EIT-team/Mini_CS_Altium/Project Outputs for Mini_CS/Mini_CS_BOM.xlsx

Value | Pattern | Quantity | Components | Descritpion | Part number | Supplied
100k | 6-0805_M | 4 | R5, R6, R11, R12 | Resistor | CPF-A-0805B100KE1 | Customer Supplied
0.1uF | 1608[0603] | 7 | C4, C6, C8, C9, C10, C11, C14 | Capacitor (Semiconductor SIM Model) | MC0603B104K500CT | PCB Train free components
10k | 6-0805_M | 3 | R1, R4, R9 | Resistor | CPF-A-0805B10KE1 | Customer Supplied
10nF | 1608[0603] | 1 | C5 | Capacitor (Semiconductor SIM Model) | MC0603B103K500CT | PCB Train free components
10uF | 1608[0603] | 3 | C7, C12, C13 | Capacitor (Semiconductor SIM Model) | GRM188C80E106ME47D | Customer Supplied
13k | 6-0805_M | 1 | R3 | Resistor | MC01W0805113K | PCB Train free components
1uF | 1608[0603] | 1 | C2 | Capacitor (Semiconductor SIM Model) | MC0603X105K250CT | PCB Train free components
2.2nF | 1608[0603] | 1 | C3 | Capacitor (Semiconductor SIM Model) | MC0603B222K500CT | PCB Train free components
20k | 6-0805_M | 2 | R8, R14 | Resistor | CPF-A-0805B20KE1 | Customer Supplied
220pF | 1608[0603] | 1 | C1 | Capacitor (Semiconductor SIM Model) | MC0603N221J500CT | PCB Train free components
330 | 6-0805_M | 1 | R13 | Resistor | MC01W08051330R | PCB Train free components
50k | 6-0805_M | 1 | R7 | Resistor | ERA6AEB513V | Customer Supplied
5k | 6-0805_M | 1 | R10 | Resistor | CPF-A-0805B5K1E1 | Customer Supplied
715 | 6-0805_M | 1 | R2 | Resistor | ERJ6ENF7150V | Customer Supplied
AD9833BRMZ | ADI-RM-10_M | 1 | U2 | Low Power, 12.65 mW, 2.3 V to 5.5 V, Programmable Waveform Generator, 10-Bit, Serial, RM-10, 50 Tube, Pb-Free | AD9833BRMZ | Customer Supplied
ADG731BSUZ | ADI-SU-48_N | 2 | U4, U5 | 1.8 to 5.5 V / +/-2.5 V, 4 Ohm, Serially Controlled, 32-Channel Analog Multiplexer, -40 to 85 degC, 48-pin QFP (SU-48), Tray |  | Customer Supplied
Header 16X2 | FTSH-117-XX-XXX-DH | 1 | P4 | Header, 16-Pin, Dual row |  | Customer Supplied
Header 4X2 | HDR2X4 | 2 | P1, P5 | Header, 4-Pin, Dual row | 2213S-08G | Customer Supplied
LTC1044ACS8 | LT-S8-8_M | 1 | U6 | 12 V CMOS Voltage Converter, 8-pin SOIC (S8-8), 0 to 70 degC | LTC1044CS8#PBF | Customer Supplied
LTC6900IS5#PBF | LT-TSOT-23-5_V | 1 | U7 | Low Power, Resistor Set Oscillator, 1 KHz to 20 MHz, 2.7 to 5.5 V, -40 to 85 degC, 5-Pin SOT-23 (S5), Pb-Free | LTC6900CS5#TRMPBF | Customer Supplied
OPA2188AIDR | D0008A_L | 2 | U1, U3 | 0.03 uV/degC, 6 uV Vos, Low Noise, Rail-to-Rail Output, Zero-Drift Operational Amplifier, 4 to 36 V, -40 to 105 degC, 8-pin SOIC (D8), Green (RoHS & no Sb/Br) | OPA2188AIDR | Customer Supplied
TLMS1100-GS08 | VISH-TLMX1100_V | 1 | DS1 | LED, RED, 2.1 V, -40 to 100 degC, 2-Pin SMD (0603), RoHS, Tape and Reel | TLMS1100-GS08 | Customer Supplied
