EIT-team/Mini_CS_Altium/Project Outputs for Mini_CS/Mini_CS_BOM.xls

Comment | Value | Description | Designator | Footprint | LibRef | Quantity | PCBTrain free component? | Farnell Reference
150pF | 150pF | Capacitor (Semiconductor SIM Model) | C1 | 1608[0603] | Cap Semi | 1 | PCBTrain Free Component | 1759068
1.5nF | 1.5nF | Capacitor (Semiconductor SIM Model) | C2, C3 | 1608[0603] | Cap Semi | 2 | PCBTrain Free Component | 1759091
0.1uF | 0.1uF | Capacitor (Semiconductor SIM Model) | C4, C6, C8, C9, C10, C11, C14 | 1608[0603] | Cap Semi | 7 | PCBTrain Free Component | 1759037
10nF | 10nF | Capacitor (Semiconductor SIM Model) | C5 | 1608[0603] | Cap Semi | 1 | PCBTrain Free Component | 1759102
10uF | 10uF | Capacitor (Semiconductor SIM Model) | C7, C12, C13 | 1608[0603] | Cap Semi | 3 | Customer supplied
TLMS1100-GS08 |  | LED, RED, 2.1 V, -40 to 100 degC, 2-Pin SMD (0603), RoHS, Tape and Reel | DS1 | VISH-TLMX1100_V | CMP-1666-00027-1 | 1 | Customer supplied
MHDR2X18 |  | Header, 18-Pin, Dual row - Omnetics | P3 | A79025-001 | MHDR2X18 | 1 | Customer supplied
Header 16X2 |  | Header, 16-Pin, Dual row - SAMTEC | P4 | FTSH-117-XX-XXX-DH | Header 16X2 | 1 | Customer supplied
Header 4X2 |  | Header, 4-Pin, Dual row | P5 | HDR2X4 | Header 4X2 | 2 | Customer supplied
10k (0.1%) | 10k | Resistor | R1, R9 | 6-0805_M | Res1 | 2 | Customer supplied
1.1k | 1.1k | Resistor | R2 | 6-0805_M | Res1 | 1 | PCBTrain Free Component | 2350953
9.1k | 9.1k | Resistor | R3 | 6-0805_M | Res1 | 1 | PCBTrain Free Component | 2129193
1k | 1k | Resistor | R4 | 6-0805_M | Res1 | 1 | PCBTrain Free Component | 2129113
0.1% | 100K | Resistor | R5, R6, R11, R12 | 6-0805_M | Res1 | 4 | Customer supplied
50k | 50k | Resistor | R7 | 6-0805_M | Res1 | 1 | Customer supplied
20k | 20k | Resistor | R8, R14 | 6-0805_M | Res1 | 2 | Customer supplied
5k | 5k | Resistor | R10 | 6-0805_M | Res1 | 1 | Customer supplied
330 | 330 | Resistor | R13 | 6-0805_M | Res1 | 1 | PCBTrain Free Component | 2129074
OPA2188AIDR |  | 0.03 uV/degC, 6 uV Vos, Low Noise, Rail-to-Rail Output, Zero-Drift Operational Amplifier, 4 to 36 V, -40 to 105 degC, 8-pin SOIC (D8), Green (RoHS & no Sb/Br) | U1, U3 | D0008A_L | CMP-0272-00241-3 | 2 | Customer supplied
AD9833BRMZ |  | Low Power, 12.65 mW, 2.3 V to 5.5 V, Programmable Waveform Generator, 10-Bit, Serial, RM-10, 50 Tube, Pb-Free | U2 | ADI-RM-10_M | CMP-0293-00077-1 | 1 | Customer supplied
ADG731BSUZ |  | 1.8 to 5.5 V / +/-2.5 V, 4 Ohm, Serially Controlled, 32-Channel Analog Multiplexer, -40 to 85 degC, 48-pin QFP (SU-48), Tray | U4, U5 | ADI-SU-48_N | CMP-0798-00240-1 | 2 | Customer supplied
LTC1044ACS8 |  | 12 V CMOS Voltage Converter, 8-pin SOIC (S8-8), 0 to 70 degC | U6 | LT-S8-8_M | CMP-0475-00491-1 | 1 | Customer supplied
LTC6900IS5#PBF |  | Low Power, Resistor Set Oscillator, 1 KHz to 20 MHz, 2.7 to 5.5 V, -40 to 85 degC, 5-Pin SOT-23 (S5), Pb-Free | U7 | LT-TSOT-23-5_V | CMP-2000-06612-1 | 1 | Customer supplied
