EIT-team/Mini_CS_Altium/Mini_CS.pdf

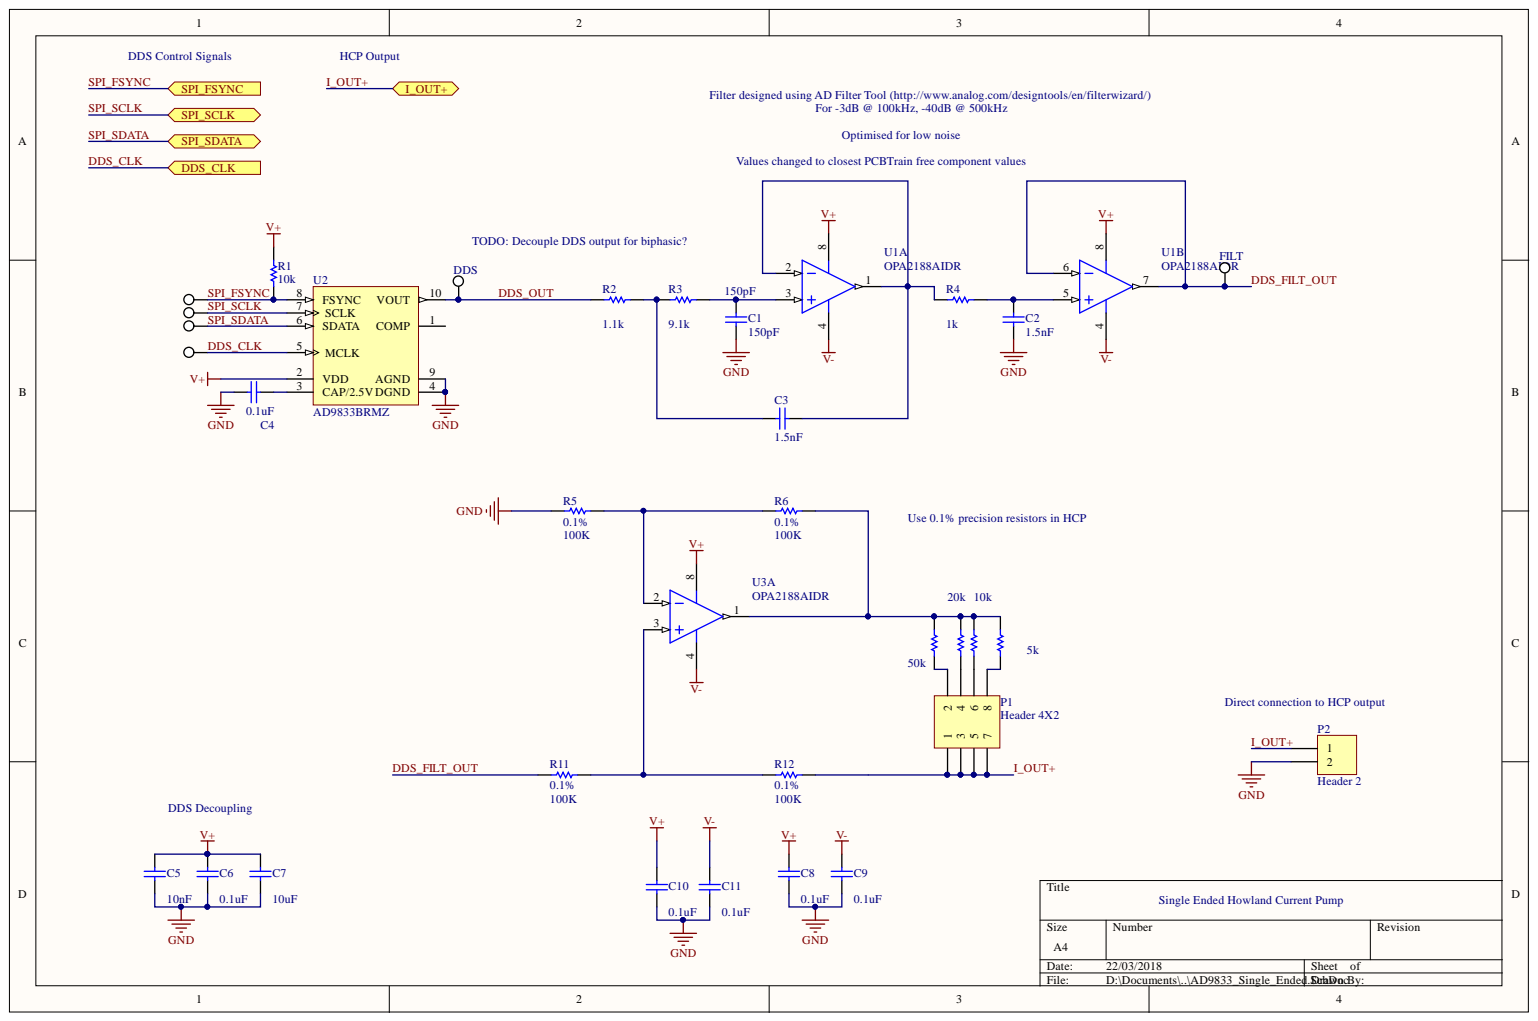
[picture p8: page 1]

Filter designed using AD Filter Tool (http://www.analog.com/designtools/en/filterwizard/)

Optimised for low noise

Values changed to closest PCBTrain free component values

TODO: Decouple DDS output for biphasic?

Use 0.1% precision resistors in HCP

Direct connection to HCP output

Single Ended Howland Current Pump

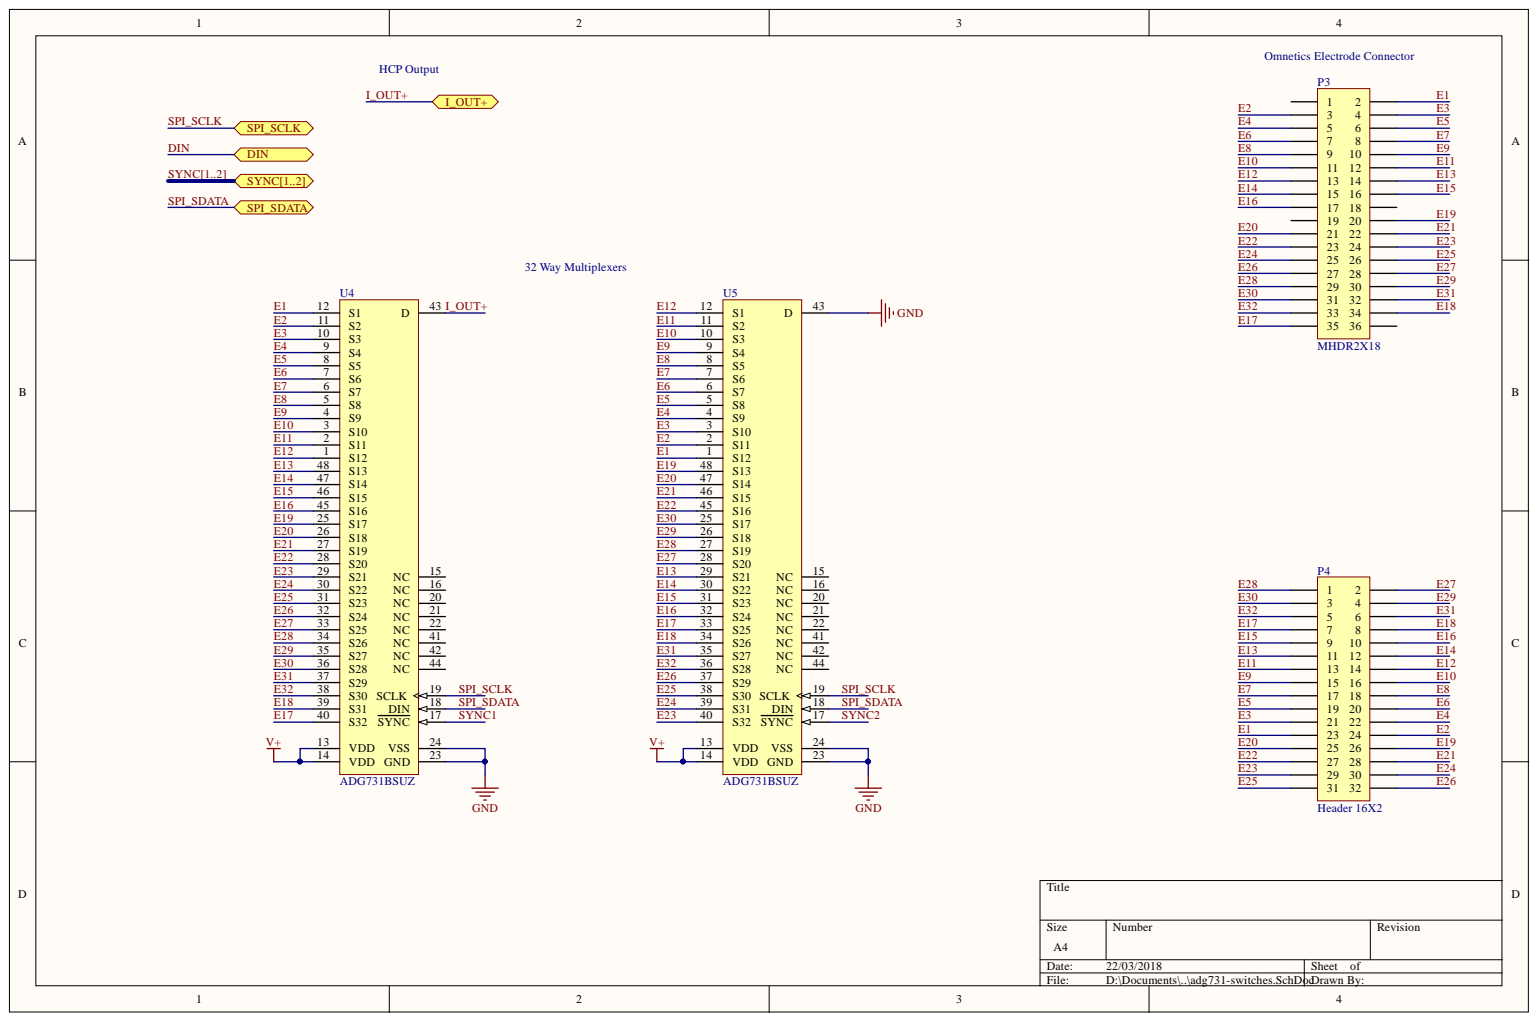
[picture p9: page 2]

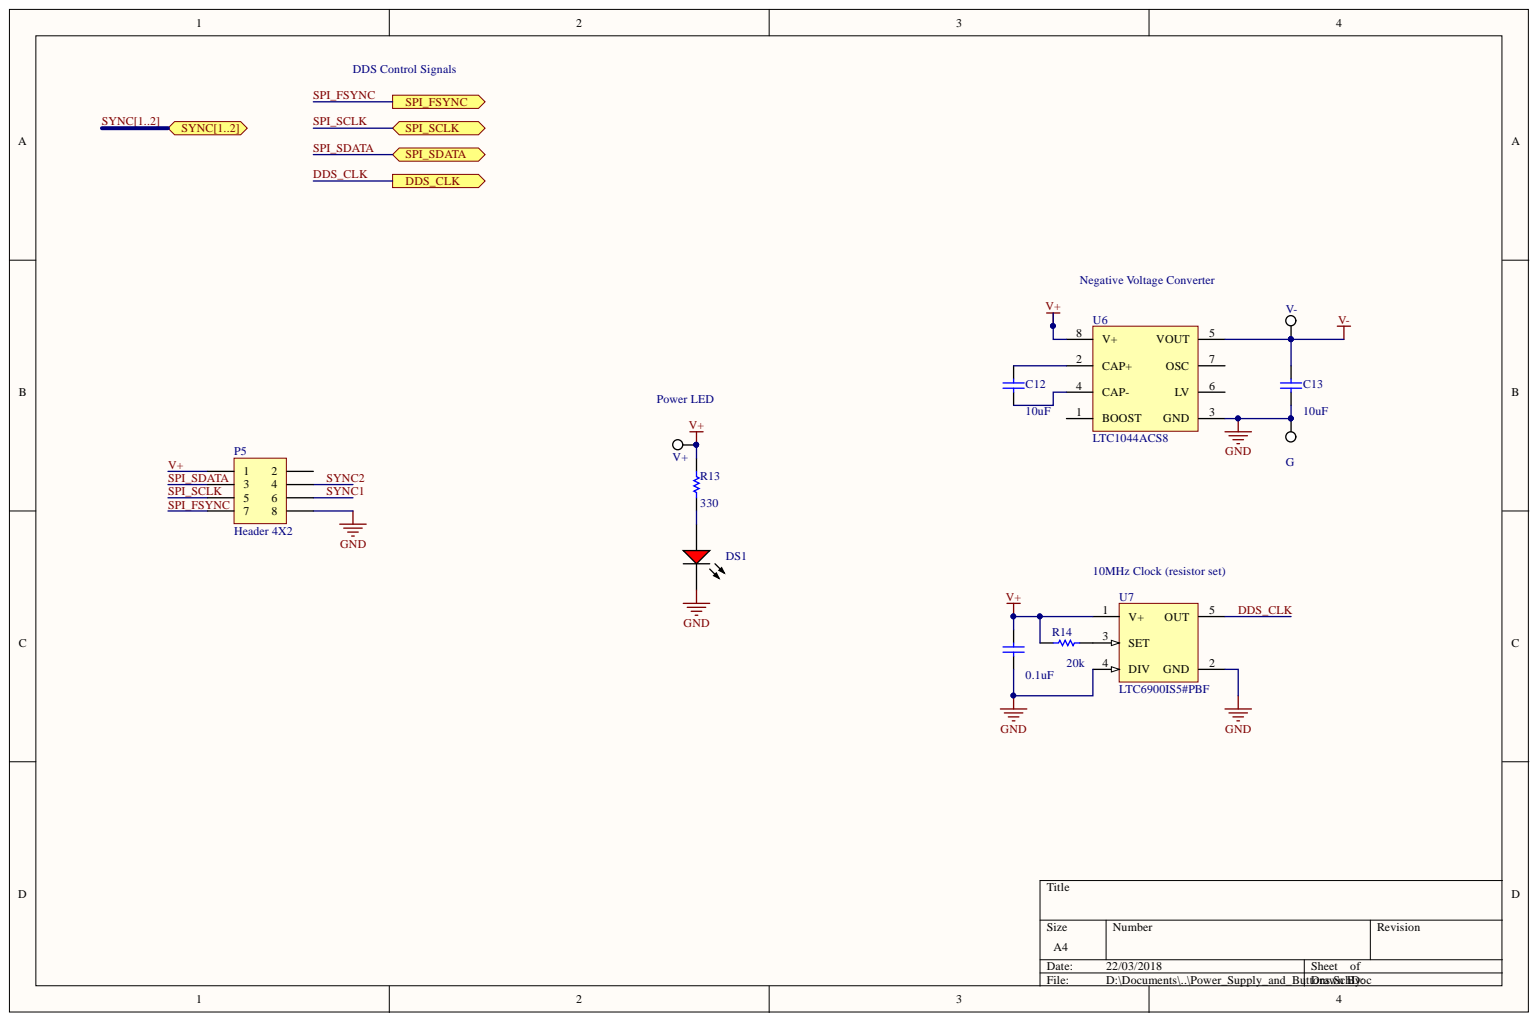
[picture p10: page 3]

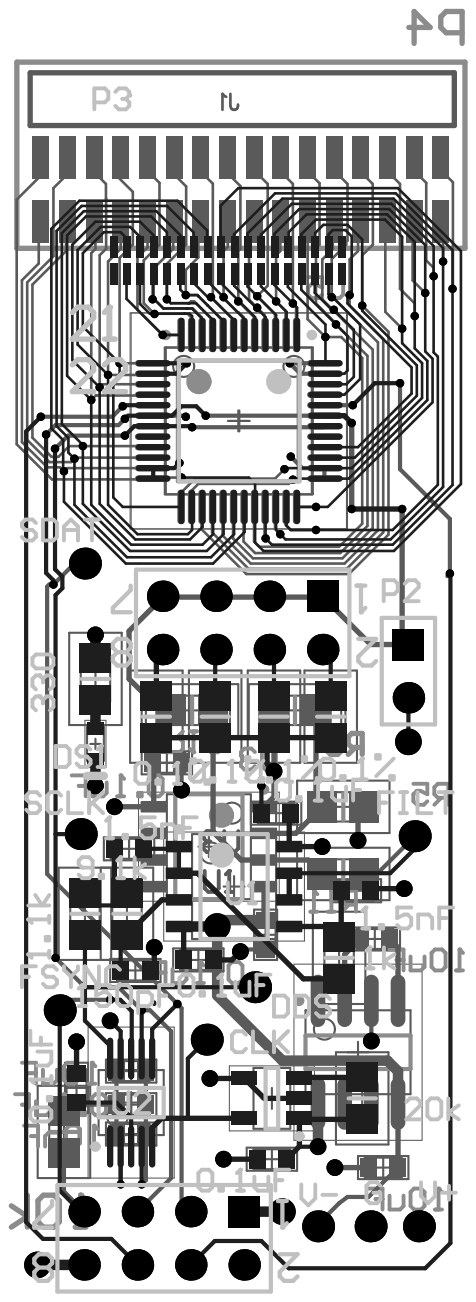
[picture p11: page 4]

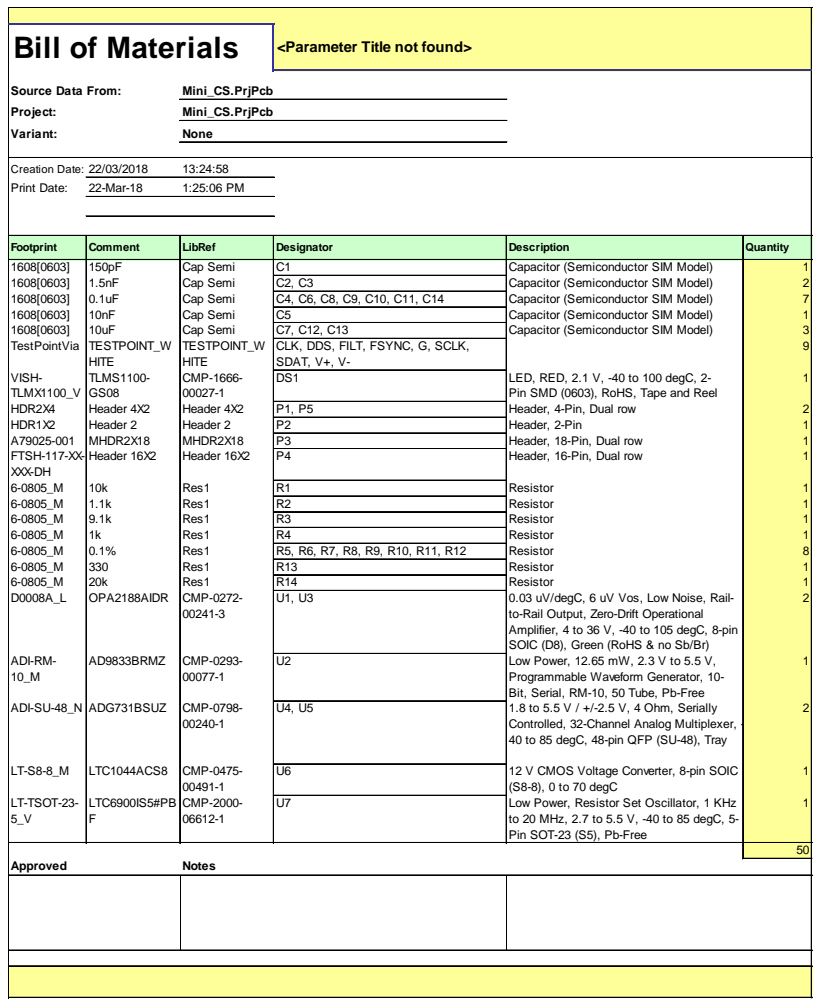
[picture p12: page 5]

CLK, DDS, FILT, FSYNC, G, SCLK,
SDAT, V+, V-

Pin SMD (0603), RoHS, Tape and Reel

to-Rail Output, Zero-Drift Operational
Amplifier, 4 to 36 V, -40 to 105 degC, 8-pin
SOIC (D8), Green (RoHS & no Sb/Br)

Programmable Waveform Generator, 10-
Bit, Serial, RM-10, 50 Tube, Pb-Free

Controlled, 32-Channel Analog Multiplexer, -
40 to 85 degC, 48-pin QFP (SU-48), Tray

to 20 MHz, 2.7 to 5.5 V, -40 to 85 degC, 5-
Pin SOT-23 (S5), Pb-Free
