EIT-team/Mini_CS_Altium/doc/Mini_CS.pdf

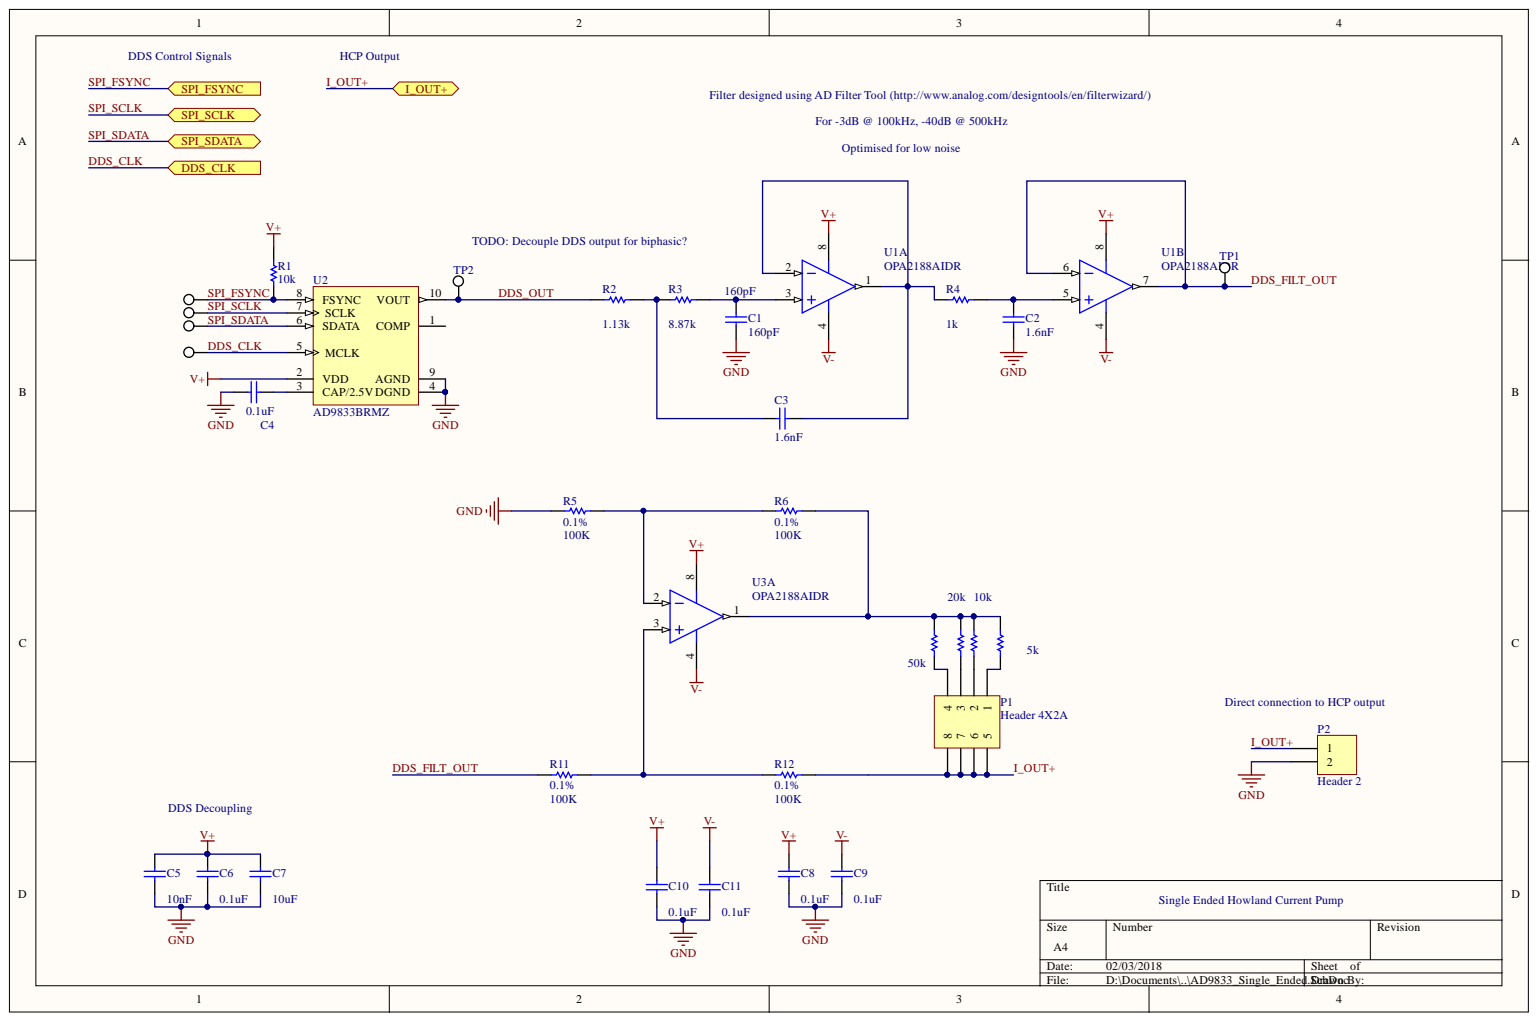
[picture p13: page 1]

Filter designed using AD Filter Tool (http://www.analog.com/designtools/en/filterwizard/)

Optimised for low noise

TODO: Decouple DDS output for biphasic?

Direct connection to HCP output

Single Ended Howland Current Pump

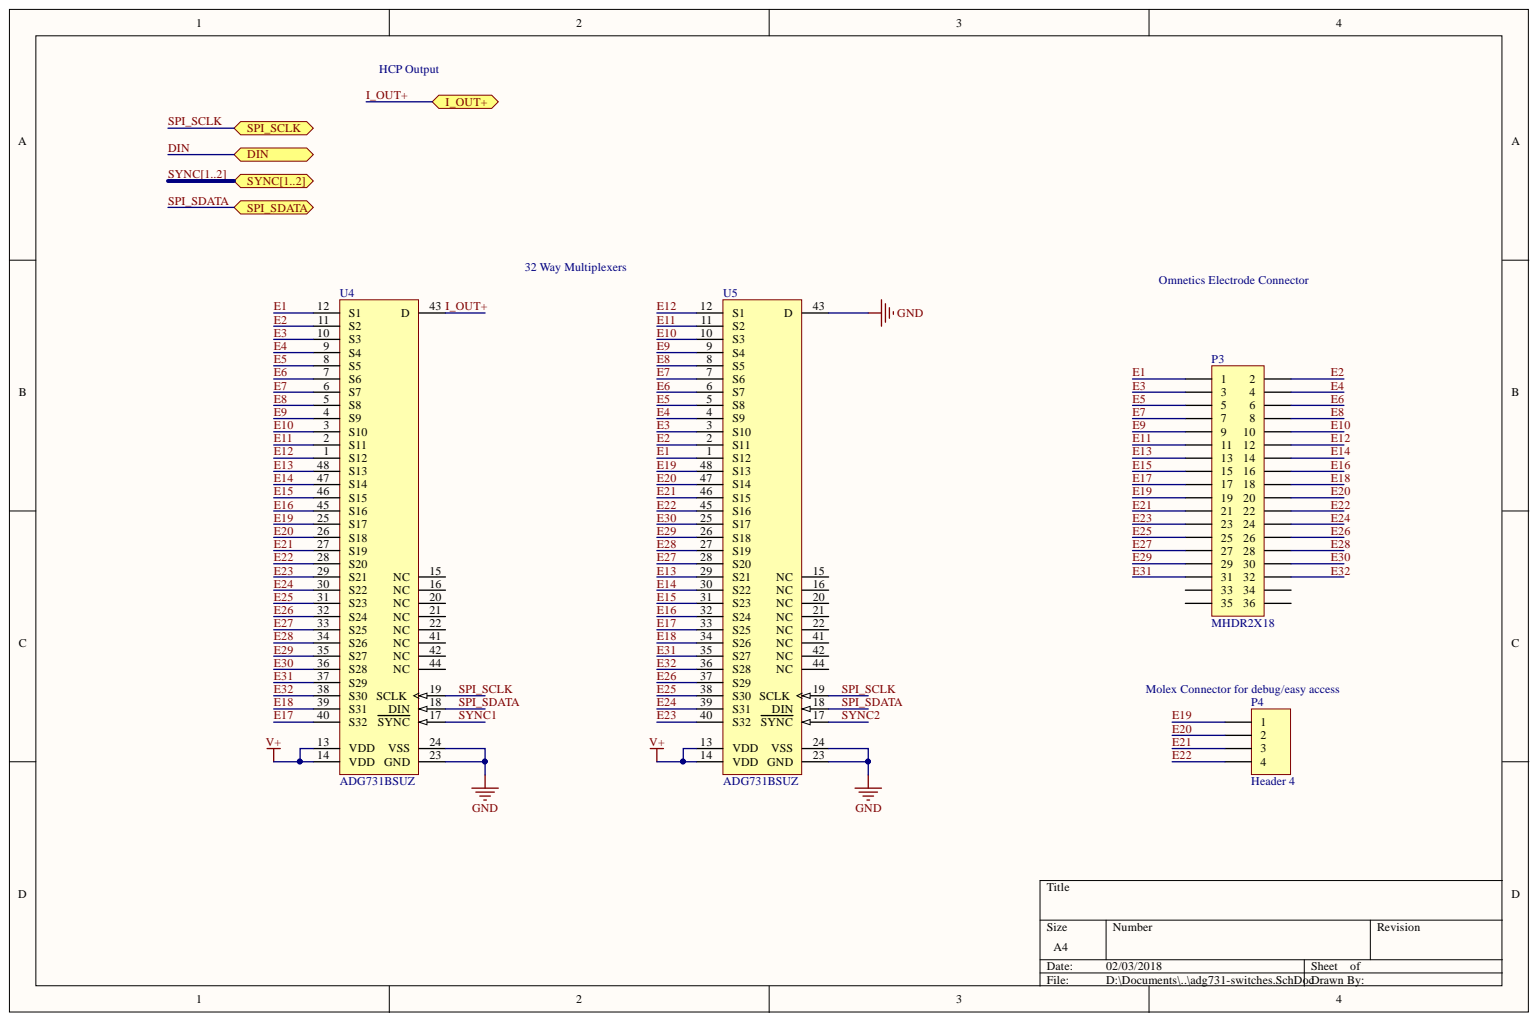
[picture p14: page 2]

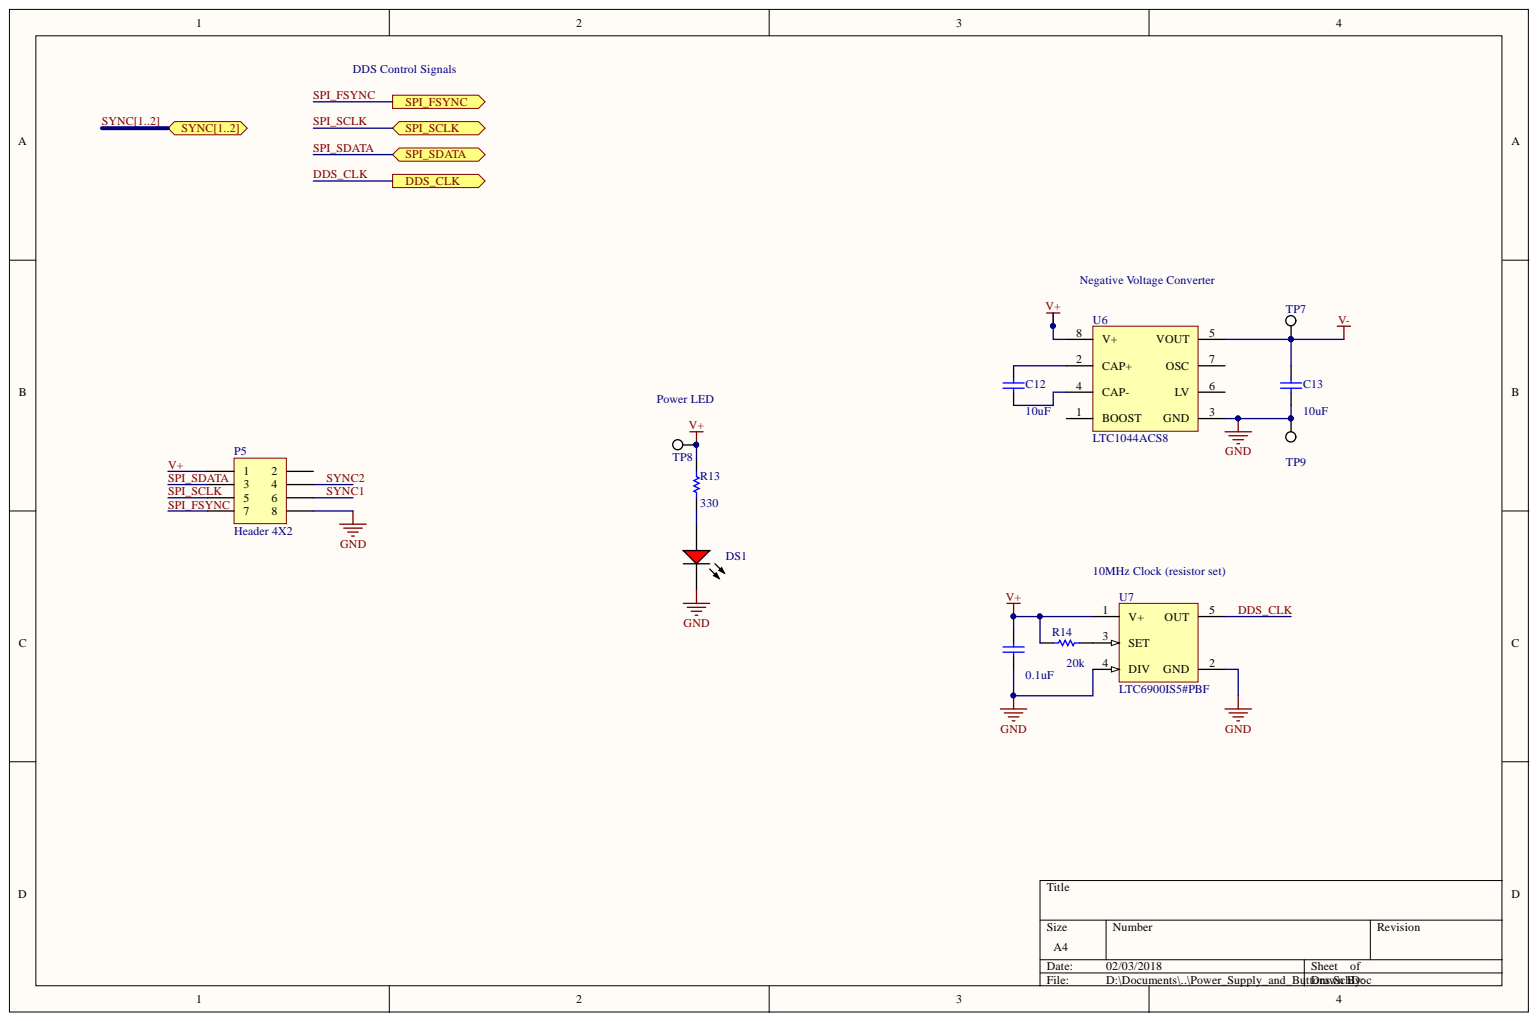
[picture p15: page 3]

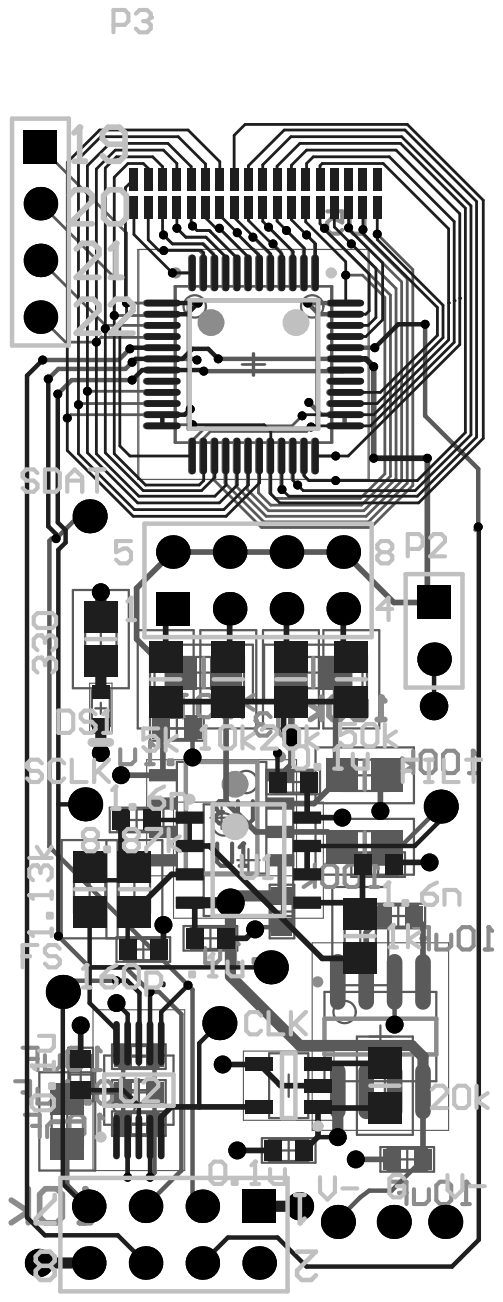
[picture p16: page 4]
