EIT-team/Mini_CS_Altium/(list of files, drawings)

Other design files:
AD9833_Single_Ended.SchDoc
adg731-switches.SchDoc
MCU.SchDoc
Mini_CS.PcbDoc
Mini_CS.PcbLib
Mini_CS.PrjPcb
Mini_CS_Top.SchDoc
Power_Supply_and_Buttons.SchDoc
