EIT-team/Mini_CS_Altium/src/DDS_PCB/frequencies.h

/* User can set the frequencies for the DDS chips here */

#ifndef frequencies_h
#define frequencies_h

#define NUM_CHANNELS 1

#define FREQ_1 2000
#define FREQ_2 2000
#define FREQ_3 3000
#define FREQ_4 4000
#define FREQ_5 5000
#define FREQ_6 6000
#define FREQ_7 7000
#define FREQ_8 8000

long Freqs[NUM_CHANNELS] = {	FREQ_1};

#endif
