EIT-team/Mini_CS_Altium/(commit log)

2017-11-21 First commit, about to start routing
    [MCU.SchDoc, Mini_CS.PcbDoc, Mini_CS.PrjPcb, Mini_CS_Top.SchDoc, Power_Supply_and_Buttons.SchDoc]
2017-12-20 Starting 2nd iteration
    [Mini_CS.PcbDoc, Mini_CS.PrjPcb, Power_Supply_and_Buttons.SchDoc]
2018-01-04 V2 board ready to send off
    [Mini_CS.CSV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]
2018-02-06 Fixed bugs for V2, moved files that were in Parallel_CS project to this one
    [AD9833_Single_Ended.SchDoc, Mini_CS.PcbDoc, Mini_CS.PrjPcb, Power_Supply_and_Buttons.SchDoc, adg731-switches.SchDoc]
2018-02-07 Before gerber generation
    [Mini_CS.PcbDoc]
2018-03-02 Updated schematic/pcb files
    [Mini_CS.PcbDoc, Mini_CS.PrjPcb, Power_Supply_and_Buttons.SchDoc]
2018-03-02 Added PDF of schematic
2018-03-02 Added circuit description
2018-03-14 Shifted electrode numbering so that end 2 electrodes in each row are empty
    [Mini_CS.PcbDoc, Power_Supply_and_Buttons.SchDoc, adg731-switches.SchDoc]
2018-03-14 Routed 2nd output connector (Samtec)
    [Mini_CS.PcbDoc]
2018-03-15 Changed components to make use of PCB Train free components
    [AD9833_Single_Ended.SchDoc, Mini_CS.PcbDoc, Mini_CS.PrjPcb, Power_Supply_and_Buttons.SchDoc, adg731-switches.SchDoc]
2018-03-15 Added integrated library
    [Mini_CS.PcbLib, Mini_CS.PrjPcb]
2018-03-15 BOM and Pick/Place
    [Mini_CS_BOM.xls, Pick Place for Mini_CS.csv]
2018-03-22 Added source code
    [Mini_CS_BOM.xls, Pick Place for Mini_CS.csv]
2018-03-22 Updated gerber files and assembly data
    [Mini_CS.CSV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]
2018-04-20 Added DC removing filter
    [AD9833_Single_Ended.SchDoc, Mini_CS.CSV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]
